Beardmix/CriticalMass_SmartBike/periph_hw/README.md

# Hardware Guide

## Electronic sketch
There is an available sketch "sketch.fzz"
It can be viewed with <a href="http://fritzing.org/home/">Fritzing</a>:

## Pre-requisites
Here is the list of all the items you will need to aquire in order to have the project up and running:
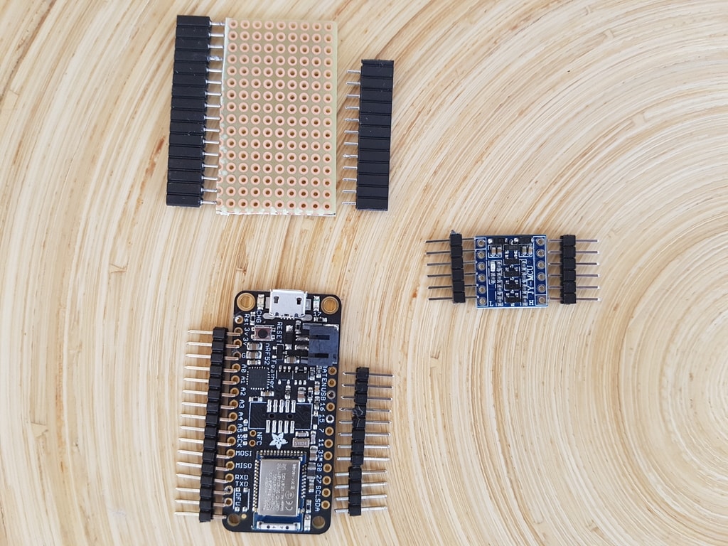
[picture p6: periph_hw/resources/pictures/step1_prerequisites.jpg]
Summary of items

1. <a href="https://www.amazon.de/gp/product/B01LXHUG4G/ref=oh_aui_search_detailpage?ie=UTF8&psc=1">WS2812B LED Strip</a>
1. <a href="https://www.amazon.de/Adafruit-Feather-nRF52-Bluefruit-LE/dp/B071ZSQDSJ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">Adafruit Feather nRF52 Bluefruit LE</a>
2. 3.3V to 5V logic shifter like the
<a href="https://www.amazon.de/XCSOURCE%C2%AE-Logisches-Konverter-Bi-Direktional-TE291/dp/B0148BLZGE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">XCSOURCE Bi-directional logic shifter</a>
3. <a href="https://www.amazon.de/WITTKOWARE-Punktraster-experimentierplatine-100x160x1-35%C2%B5m/dp/B07CHQYSTG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">Soldering board</a>
4. <a href="https://www.conrad.de/de/mpe-garry-buchsenleiste-praezision-anzahl-reihen-1-polzahl-je-reihe-36-115-1-036-0-mtf-xs0-1-st-733779.html">Pin headers female</a>
5. <a href="https://www.amazon.de/OneCreation-m%C3%A4nnlicher-weiblicher-LED-Verbindungsst%C3%BCck-Kabel-LED-Streifen-Lampe/dp/B01DA5QB04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">JST-SM cable connectors</a>
6. <a href="https://www.conrad.de/de/strapubox-mg-2-a-modul-gehaeuse-55-x-36-x-30-abs-grau-1-st-522341.html">Wrapping box</a>

## Step by Step assembling
### 1. Soldering the pin headers on the boards
| Front | Back |
| --- | --- |
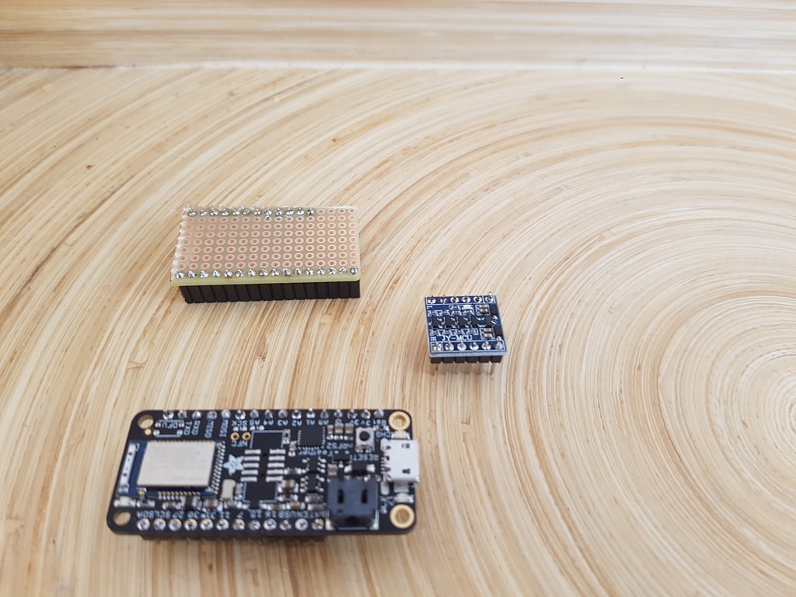
[picture p7: periph_hw/resources/pictures/step2_soldering_back.jpg]
Soldering, back-side view
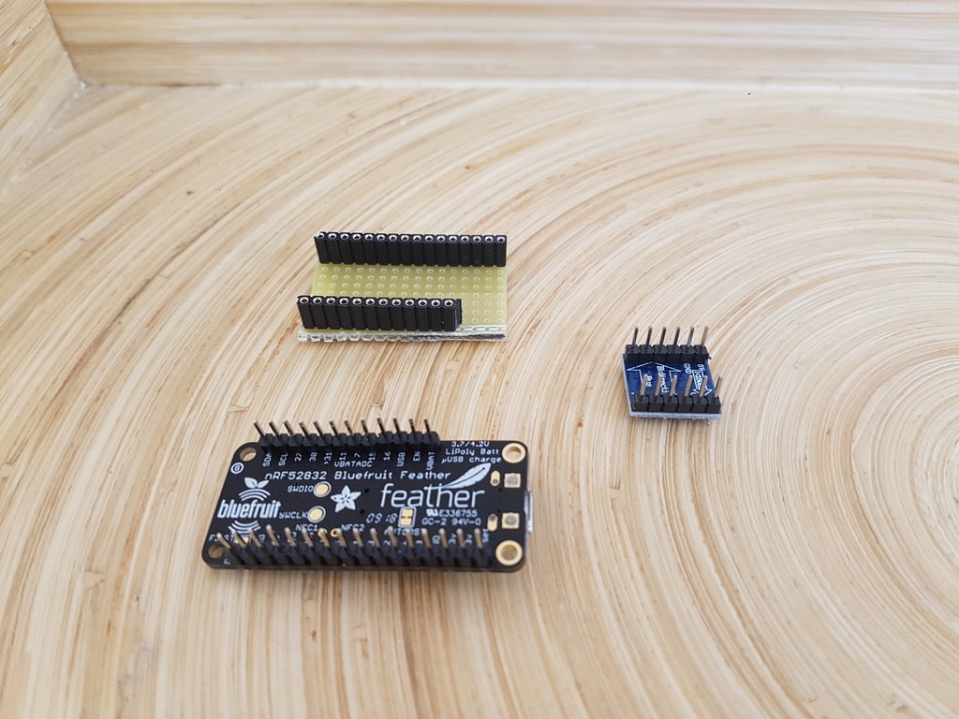
[picture p8: periph_hw/resources/pictures/step2_soldering_front.jpg]
Soldering, front-side view
|  |  |

### 2. Soldering the logic shifter on the soldering board
| Front | Back |
| --- | --- |
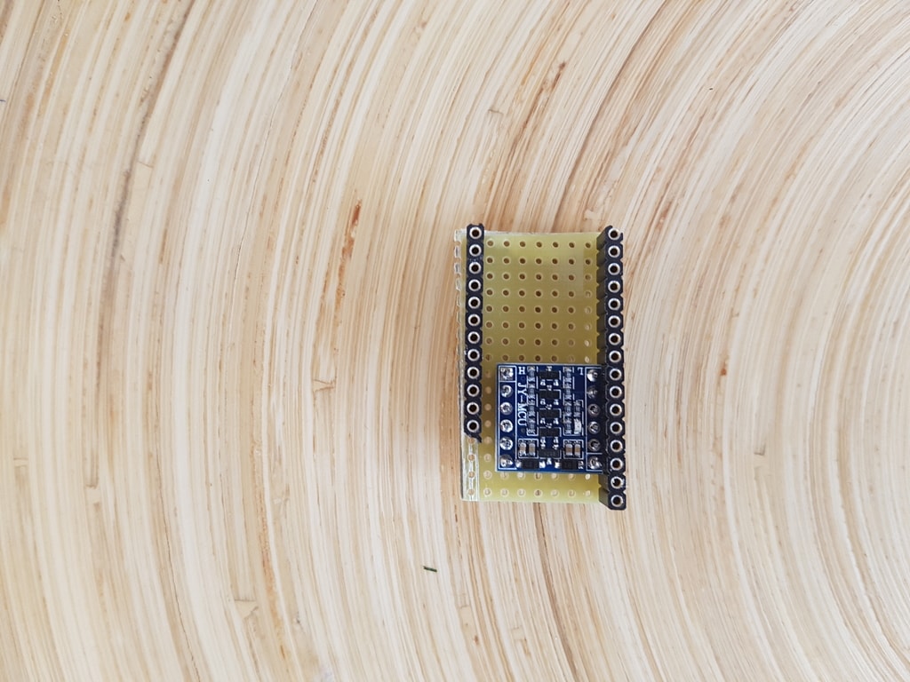
[picture p9: periph_hw/resources/pictures/step3_soldering_logic_shifter_front.jpg]
Soldering the logic shifter, front-side view
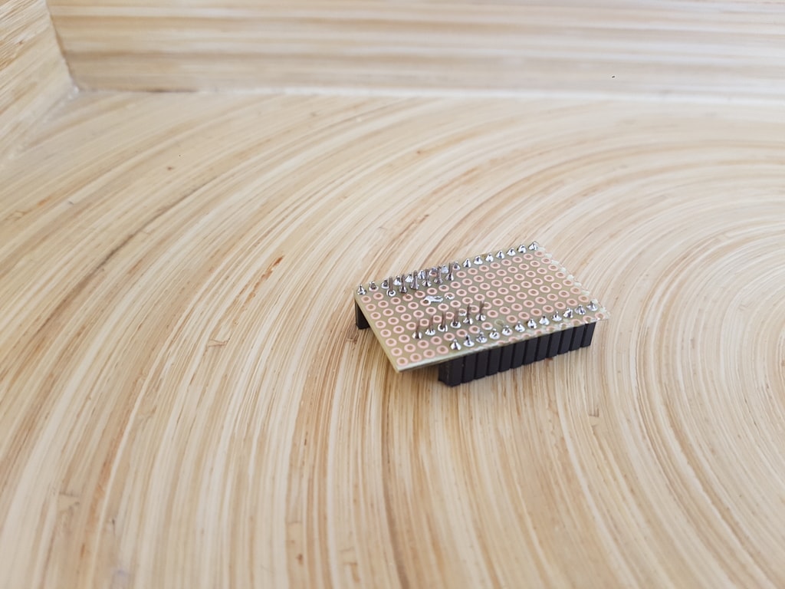
[picture p10: periph_hw/resources/pictures/step3_soldering_logic_shifter_back.jpg]
Soldering the logic shifter, back-side view
|  |  |

### 3. Soldering GND and VCC between nRF52 and logic shifter
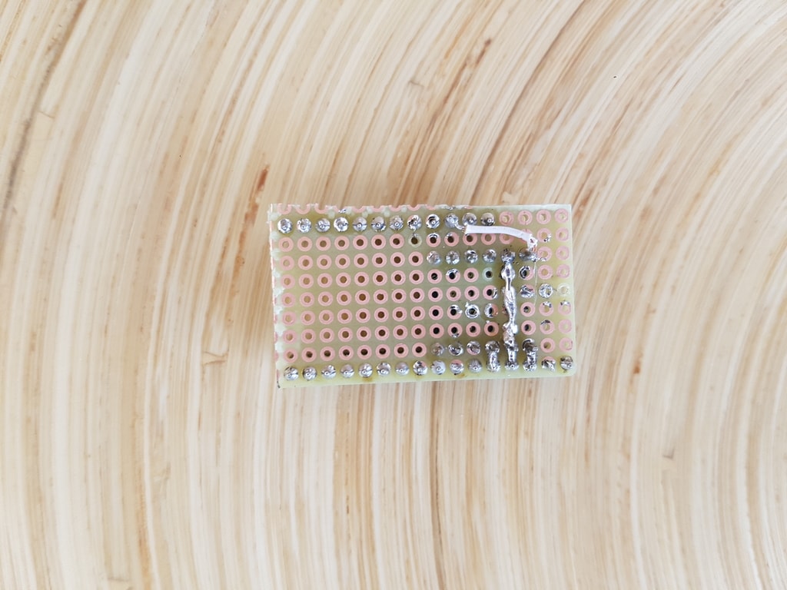
[picture p11: periph_hw/resources/pictures/step4_soldering_gnd_and_vcc.jpg]
GND and VCC connections

### 4. Connecting the LED cable, to test the connections
| Off | On |
| --- | --- |
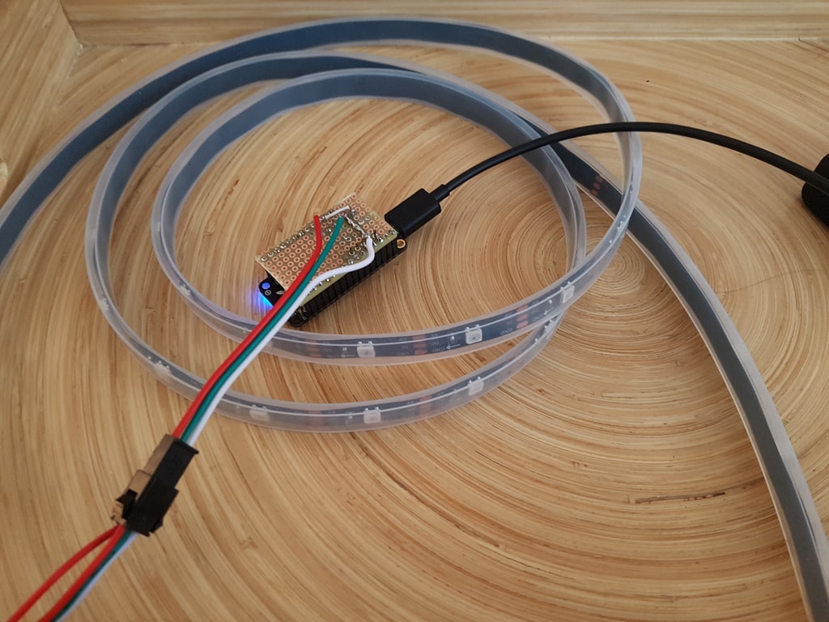
[picture p12: periph_hw/resources/pictures/step5_led_connect_off.jpg]
LED Cable connection, offline
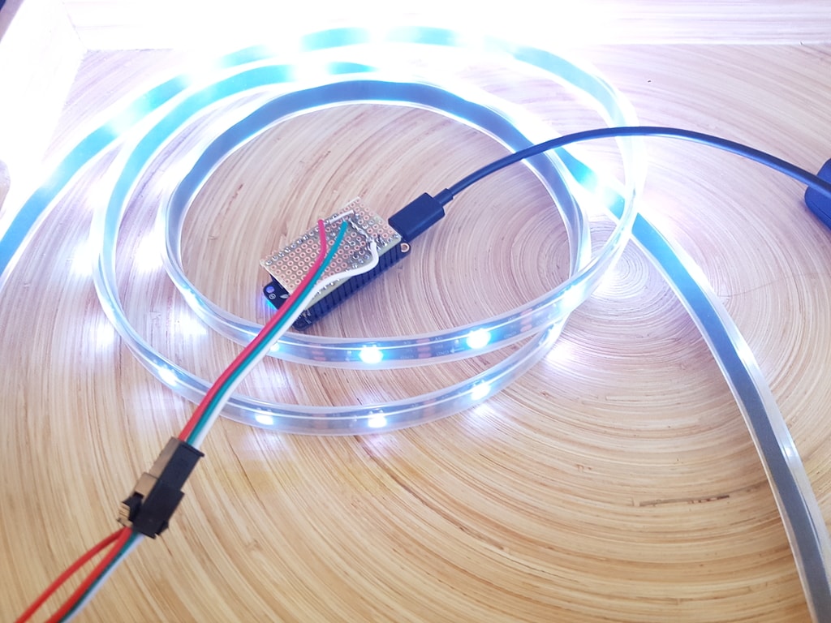
[picture p13: periph_hw/resources/pictures/step5_led_connect_on.jpg]
LED Cable connection, online
|  |  |

### 5. Installing the device in the box
| Cable connecions | Off | On |
| --- | --- | --- |
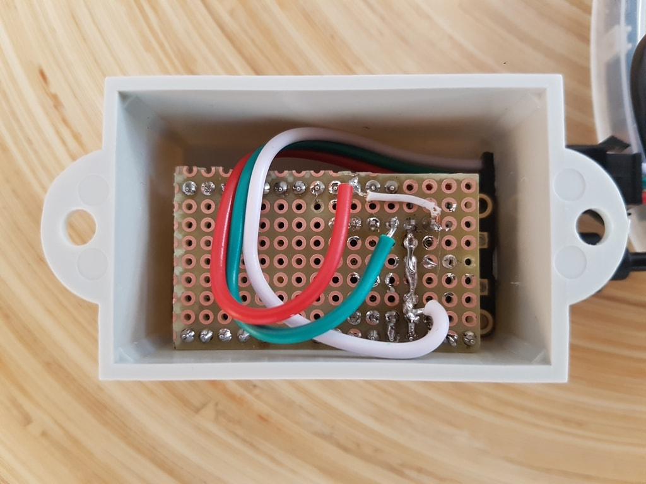
[picture p14: periph_hw/resources/pictures/step6_wrapping_connections.jpg]
LED cable connections
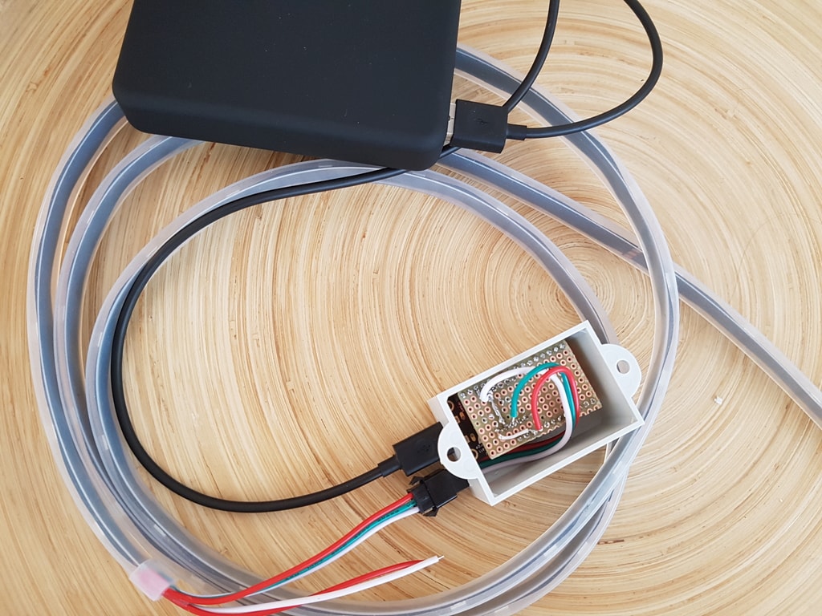
[picture p15: periph_hw/resources/pictures/step6_wrapping_box_off.jpg]
Box wrap-up, offline
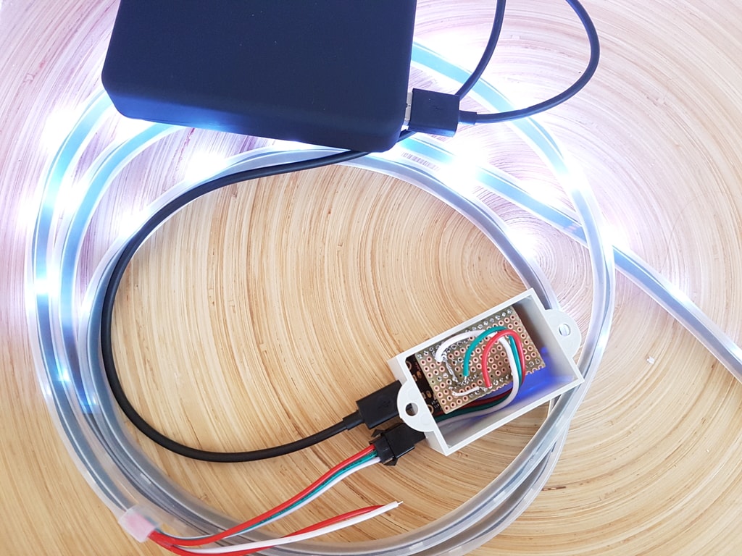
[picture p16: periph_hw/resources/pictures/step6_wrapping_box_on.jpg]
Box wrap-up, online
|  |  |  |
