Beardmix/CriticalMass_SmartBike/(threads)

Thread 12 (2018-06-17):

Peripheral crashes when disconnected from Master

OnizukaX, 2018-06-17:
When the Master disconnects from the Peripherals, Peripherals might crash. Rootcause unknown.

OnizukaX, 2018-06-18:
After some testing, this seems to have to do with the Adafruit_NeoPixel library.
Having the strip.show() calls commented out keeps the Peripheral working when disconnected from Central: are interrupts responsible?

OnizukaX, 2018-06-18:
Refering to the task scheduler section of the nRF52 doc: https://learn.adafruit.com/bluefruit-nrf52-feather-learning-guide/faqs#faq-5
> How are Arduino sketches executed on the nRF52832? Can I do hard real time processing (bit-banging NeoPixels, etc.)?
In order to run Arduino code on the nRF52 at the same time as the low level Bluetooth Low Energy stack, the Bluefruit nRF52 Feather uses FreeRTOS as a task scheduler. The scheduler will automatically switch between tasks, assigning clock cycles to the highest priority task at a given moment. This process is generally transparent to you, although it can have implications if you have hard real time requirements. There is no guarantee on the nRF52832 to meet hard timing requirements when the radio is enabled an being actively used for Bluetooth Low Energy. This isn't possible on the nRF52832 even without FreeRTOS, though, since the SoftDevice (Nordic's propietary binary blob stack) has higher priority than any user code, including control over interrupt handlers.

Refering to the FreeRTOS hook functions: https://www.freertos.org/a00016.html

So far no hooks seems to handle this unknown issue.

OnizukaX, 2018-09-30:
Problem still occuring with Adafruit nrf52 Arduino Core 0.8.6.

Somehow almost no crash seem to happen when compiling with:
**Debug Mode: "Level 3 (Segger SystemView)"**.

wwwoholic, 2018-11-18:
Still occurring with 0.9.0
I noticed that it is easier to trigger this error if nodes are actively exchanging data (100~300 Bps) and one of the nodes is simply rebooted.

OnizukaX, 2019-04-06:
Solved in v1.1.8 - https://github.com/adafruit/Adafruit_NeoPixel/releases/tag/1.1.8

Closed 2019-04-06.

Thread 2 (2018-06-17):

Adding Settings to Arduino

Beardmix, 2018-06-17:
When connected to a single bike, the owner should be able to personalize the settings of the lights.

For example:
- Number of LEDs
- Name of the bike
- Mounting Style (from front to rear, as a triangle, ...)
- ...

The phone has to have a settings menu
The peripheral has to be able to save in the EEPROM
The peripheral has to be able to retrieve from the EEPROM
A communication of the settings has to be set (from periph to phone and from phone to periph)

Beardmix, 2018-06-17:
The Library EEPROM is not accessible for the hardware. (EEPROM.h is not found)
Instead, tried to use Nffs which is also the one used from Adafruit.
Issues while creating a new file. da95df8

Beardmix, 2018-06-18:
NFFS could not write to the eeprom as the memory was full (filled with paired devices).
Using the examples from the library did not work neither, until using the example to clear the memory.
`EraseNffs.ino` is the script to use to clear the memory. An adaptation could be made to limit the space taken by the paired devices.

Could this also be linked to other issues?

Beardmix, 2018-06-18:
Saving and Loading settings work --> bc13b2e
Default values are set and saved if no previous values.

After loading settings, they should be re-saved to incorporate default values in case one is not loaded.

Beardmix, 2018-06-19:
Sending and receiving of new settings working. Saving settings in the ROM.

Missing sending the settings at first connection.

There might be issues when the memory is full and one can not save any longer.
Maybe check for error message 3. If so, clear memory and resave.

Beardmix, 2018-06-24:
0bc8450
Interface to change name and number of LEDs created.
Still some bugs with ROM saving (errors in saving or closing the file - needs a memory clear).
No answer from the device can be sent in the `connect_callback` as the phone is not yet listening to the device.

Filter devices using Manufacturer and not Name.

Beardmix, 2018-06-24:
7046ae4

After a successful connection, the phone asks the device for its settings.

Closed 2018-07-17.

Thread 4 (2018-06-17):

Devices meshing with a Master

Beardmix, 2018-06-17:
Try to mesh the devices between them, and having a single Master (the closest to the phone?).
This would allow faster communication between devices (the BLE stack is not disturb by an OS) and increase the range of communication.
With this, it is also hoped that the time synchronization would be more accurate (due to BLE stack speed).

OnizukaX, 2018-08-16:
Depends on [Bluetooth LE Mesh open issue](https://github.com/adafruit/Adafruit_nRF52_Arduino/issues/64 )?

Thread 5 (2018-06-17):

Documentation

Beardmix, 2018-06-17:
We want to make the project available to more contributors and that it could be used without the core team's participation.
More documentation is needed in order to explain the project, the current status, how to use it, ...

A good start would be to have a more detailed ReadMe page and include a short video of demonstration.

htjjen, 2018-06-21:
I can add more details on "Install Android Studio or Only Line Command" and "Activate developer mode on your Android" - would that help?

Thread 7 (2018-06-17):

Organise Testing

Beardmix, 2018-06-17:
It is hard to test most of the features alone, and generally at least 2 devices are necessary to group features.
One should organize regularly testing events to be able to enhance the quality of the product.

Things to test:
- Time synchronization (find a protocol for testing it)
- Connection stability / robustness
- Range of connection (with or without mesh)
- ...

Thread 8 (2018-06-17):

Hardware

Beardmix, 2018-06-17:
1. Update the schematics of the wiring to correspond to actual hardware
2. Create a new schematics for a shield
3. Try to find ways to reduce costs of the hardware (the simplicity should be kept to a maximum)

Beardmix, 2018-06-17:
The Breadboard version of the schematics has been updated - see commit 1520f4b

Beardmix, 2018-07-17:
Hardware was updated to latest state at commit  3613b9f
3 Pieces ordered for testing and usage.

Closed 2018-07-17.

Thread 9 (2018-06-17):

Usage of Phone sensors

Beardmix, 2018-06-17:
Using the sensors embedded in the phone (GPS, accelerometers, light, ...) it should be possible to offer enhanced features.

Examples would be:
1. Red lights when braking
2. Blinking Orange when turning
3. Brightness related to speed
4. ...

Beardmix, 2018-06-17:
First prototype of accelerometer reading:
in branch accelerometer_brake, commit 7e1652a
it seems that the accelerometer is not read or read rarely when the app is in background mode.
The use of `backgroundMode.enable()` does not seem to improve anything.

The fact that the mode is called, the app forgets what were the previous settings after the brake.

Thread 14 (2018-06-21):

The Central deletes its internal handle to the Peripheral even though the disconnect call fails

OnizukaX, 2018-06-21:
When disconnecting all Peripherals the Central deletes all entries from its list of connected devices, either in case of success or failure.

It might however happens that a call to disconnect() fails. If so, the Peripheral will stay connected but the Central will not be able to interact with it anymore -> the Peripheral has to be reset.

OnizukaX, 2019-06-10:
Seems not to happen anymore with the new data workflow.

Closed 2019-06-10.

Thread 19 (2018-07-19):

Each Peripheral shall be able to define its lightning direction

OnizukaX, 2018-07-19:
Some "modes" have a lightning direction" (e.g. Theater chase, Pile up, Rainbow), the Peripheral shall retain and be able to modify its LED strip "mounting direction".

OnizukaX, 2018-08-21:
See pull request #27 for details.

note: one might be interested in changing the direction without saving the parameter into the settings file e.g. alternating modes etc. In this case, please create a new issue.

Closed 2018-08-21.

Thread 21 (2018-07-19):

Long-press should pop-up advanced options and choices which will be saved as default

artur-braga, 2018-07-19:
Each color, intensity or modes(if more available) button could be reconfigured with a new preset,
With one long-press, a pop-over will appear with more choices and presets. These can be either chosen only once, or saved as default preset for the respective button.
[Optional]:
* Reset to default App Settings
* Load/Save Custom presets for all the buttons
* Sync presets between phones

Thread 26 (2018-08-20):

Light effects are not looping on schedule when the tempo is not 60bpm

Beardmix, 2018-08-20:
The effects are made to work on a basis of 1 loop per second.
When the tempo is faster, the effect is still not finished when the loop has to start.
This produces a glitch effect in the lights that diminishes the quality of the product.

Beardmix, 2018-08-21:
Issue is not due to millis method but to the smartphone time sync.
Even if the server sends the information at the same time for each device, the devices are not synced.
Test: send server time on button push -> no sync.
Even with a single device connected, pushing the button de-synchronises the peripheral.

[solved] Issue1: The payload used to compute the server time was used directly (ascii code) and not converted to integers.
[solved] Issue2: The computation with Pow() is probably too long and can be interrupted. has been replaced by constant multiplications.
[todo] Issue3: Using a binary system with bitshift might be more efficient are reduce computation time, which in turns reduces the chances of interruption.

There are still some sporadic wrong offsets. It is probably due to interruptions.
It is possible to average or filter extreme values.

[todo]: Do an average of received time offsets (careful with overflows around 0)
[todo]: Test with multiple devices

commit: edc344a7d6ec71941dc5b42f3395ba5273174ea4

Beardmix, 2018-08-28:
fixed in commit 09388d20ab755eb6eee53ad2ebed6b4c5854f4c9

Closed 2018-08-28.

Thread 30 (2018-09-03):

Automatically determine the strip number of LEDs

OnizukaX, 2018-09-03:
At startup, the Peripheral should be able to determine how many LEDs the strip has (e.g. by reading the battery voltage level when successively adressing the LED 0..n).

The option to let the user decide how many he wants to control should be kept, only the default value is to be set during the initialisation.

OnizukaX, 2019-04-06:
Cancelled as we are not able to read the voltage level. Related to #32

Closed 2019-04-06.

Thread 31 (2018-09-05):

Crash every time the parameters are saved manually

Beardmix, 2018-09-05:
Every time the parameters are saved, the device crashes while saving, saving only a part of the parameters, and preventing further savings.
The first saving works (the one automatic after reflashing the ROM)

The error code is 2, which is define in fs.h as:
`#define FS_EHW          2  /* Error accessing storage medium */`
[https://github.com/adafruit/Adafruit_nRF52_Arduino/blob/master/libraries/nffs/src/fs/fs/include/fs/fs.h]

usually, the error was `#define FS_EOFFSET      3  /* Invalid offset */`, which was more cryptic and happened while the device was not crashing.

It is probably due to BLE interrupts, or size of parameters to save?

Full log here:

```
--- Peripheral---

File /settings.txt not found.
--------- SoftDevice Config ---------
Max UUID128     : 10
ATTR Table Size : 2048
Service Changed : 0
Peripheral Connect Setting
  - Max MTU         : 23
  - Event Length    : 3
  - HVN Queue Size  : 1
  - WrCmd Queue Size: 1

--------- BLE Settings ---------
Name            : Bluefruit52
Max Connections : Peripheral = 1, Central = 0
Address         : D9:EF:3D:CA:77:49 (Static)
TX Power        : 0 dBm
Conn Intervals  : min = 20.00 ms, max = 30.00 ms
Peripheral Paired Devices:

Central Paired Devices:

startAdv
+++ Connected +++
Pixel 2
payload sent #T60!
payload sent #C255,128,0!
payload sent #M8!
[SETTINGS] request cfg, will send chunk#1
payload sent #D1;50;0;MyFahrrad!
[SETTINGS] request cfg, will send chunk#2
payload sent #D2;1;11;38;50!
[SETTINGS] request cfg done.
[SETTINGS] ready to get cfg chunk#1
payload sent #DA!
[SETTINGS] getting cfg chunk#1 ask for chunk#2
0
payload sent #DB!
[SETTINGS] getting chunk#2
Open /settings.txt file to write ...
Writting Setting: num_pixels=50;
Writting Setting: strip_rev=0;
Writting Setting: d_name=MyFahrrad;
Writting Setting: traffic_fl=1;
Writting Setting: traffic_fu=11;
Writting Setting: traffic_rl=38;
Writting Setting: traffic_ru=50;
payload sent #S801!
payload sent #S170!
payload sent #S390!
payload sent #S950!
payload sent #S280!
payload sent #S870!
payload sent #S001!
[SETTINGS] ready to get cfg chunk#1
payload sent #DA!
[SETTINGS] getting cfg chunk#1 ask for chunk#2
1
payload sent #DB!
[SETTINGS] getting chunk#2
Open /settings.txt file to write ...
Writting Setting: num_pixels=50;
Writting Setting: strip_rev=1;
Writting Setting: d_name=Sophie;
Writting Setting: traffic_fl=42;
Error - len_written: 0 | file.errnum: 2
Writting Setting: traffic_fu=50;

```

Beardmix, 2018-09-05:
Complement:
This is the content of the ROM after a saving failure:

```
root
|_ adafruit/
|  |_ bond/
|_ lost+found/
|_ settings.txt                                    98 Bytes

```

Nothing is suspicious..

Erasing the ROM as in the example is not possible when integrated in the code (see issue on Adafruit Repo). Erasing fails after one sector successfully erased, and the file cannot be written afterwards, even if it doesn't trigger any error!

OnizukaX, 2019-06-10:
Seems to be resolved with all the latest file system changes.
 [Adafruit nRF52 v0.11.0](https://github.com/adafruit/Adafruit_nRF52_Arduino/releases/tag/0.11.0) looks fine.

Closed 2019-06-10.

Thread 32 (2018-09-06):

Display battery level

OnizukaX, 2018-09-06:
Read the Peripheral's battery level or USB-Power and display it by turning on the LEDs correponding percentage. A color indicator could be also chosen.

OnizukaX, 2019-04-06:
Battery regulators prevent battery voltage reading. Activity cancelled as we want to use plugNplay powerbanks.

Closed 2019-04-06.
