Beardmix/CriticalMass_SmartBike/(list of files, drawings)

Other design files:
periph_hw/sketch.fzz
