Beardmix/CriticalMass_SmartBike/(commit log)

2018-03-27 BLE - Fixing packet reading. BLE - Send time pull request. PhoneApp - Answer Time Request
    [nRF52_RGB_Strip.ino]
2018-03-27 BLE - use correct pin number. PhoneApp - Clean code with functions.
    [nRF52_RGB_Strip.ino]
2018-03-27 PhoneApp - Modify UI to automatically connect to MyFahrrad devices.
2018-03-30 BLE - Adding Debug Pin. Adding Flow mode
2018-03-30 BLE - Adding missing pin declaration
    [nRF52_RGB_Strip.ino]
2018-04-01 BLE - Fix decode RGB. PhoneApp - Fix encode RGB
    [nRF52_RGB_Strip.ino]
2018-04-01 HW - Adding schematics for the hardware shield
    [sketch.fzz]
2018-04-14 PhoneApp - live GUI update of connected BLE devices when pairing.
2018-04-14 PhoneApp - added bicycle icon and increased connected devices badge size.
2018-04-15 BLE - sending clock milliseconds after offset addition.
2018-04-17 PhoneApp - master initiates universal time and adjusts the delay error induced by the server stack. BLE - peripheral listens to the master to set its universal time reference.
    [led_lib.h, nRF52_RGB_Strip.ino]
2018-04-18 PhoneApp - Connecting to devices every 20s as long as not actively disconnecting.
2018-04-18 PhoneApp - Resending Mode to newly connected devices.
2018-05-07 BLE - Replacing LED control with NeoPixel Lib
2018-05-08 BLE - fix chase mode
    [led_lib.h]
2018-05-24 BLE - single access to millis(); the led library could also get a pointer to the global counter to eliminate its internal calls.
2018-05-24 PhoneApp - added "theater chase mode" button.
2018-05-31 PhoneApp - Fixing callbacks new devices
2018-05-31 BLE - Fix global variable crash
    [nRF52_RGB_Strip.ino]
2018-05-31 PhoneApp - Revert back to 2 connection buttons
2018-05-31 BLE PhoneApp - Fix first connection issues
    [nRF52_RGB_Strip.ino]
2018-06-04 BLE - moved the packet reading to the main sketch. Added some gates to lower the risk of having runtime issues.
    [nRF52_RGB_Strip.ino]
2018-06-04 BLE - added BSP configuration options to reduce the SoftDevice RAM is needed (in practice, really low impact). Printing the Bluetooth configuration at startup.
2018-06-07 BLE - reworked the NeoPixel initialisation sequence.
    [led_lib.h, nRF52_RGB_Strip.ino]
2018-06-07 BLE, Phone - removed time offset correction.
    [nRF52_RGB_Strip.ino]
2018-06-17 BLE - failing tests for EEPROM saving
    [eeprom_handler.h, nRF52_RGB_Strip.ino]
2018-06-17 update breadboard view of the hw
    [sketch.fzz]
2018-06-19 BLE - Using the name saved in the device as the BLE name
2018-06-19 BLE - Fetching the number of LEDs on the strip from the settings.
2018-06-24 BLE, Phone - filtering with Manufacturer and not Naming. Phone - Interface to change Name and number of LEDs
2018-06-24 BLE, Phone - After a new connection, requesting for device settings
2018-07-01 PhoneApp - Replacing Segments by Buttons to be able to align them as desired.
2018-07-01 PhoneApp - Change the scan buttons to a toggle. Fix the refresher.
2018-07-16 HW - Update Hardware for ordering.
    [sketch.fzz]
2018-07-19 BLE - Adding LED Strip link in the documentation
2018-08-05 Fixed settings transmission issue - split parameters into chunks (max 20 Bytes for the nrf52).
    [eeprom_handler.h, nRF52_RGB_Strip.ino]
2018-08-07 Fixed off-by-one for TrafficMode. Changed TrafficMode "sig_" param. naming for "traffic_".
    [eeprom_handler.h, led_lib.h, nRF52_RGB_Strip.ino]
2018-08-09 Fixed LEDs reminiscence issue when changing num_pixels to a smaller value - "deactivated" pixels were not controlled anymore and stayed in their previous state.
    [led_lib.h, nRF52_RGB_Strip.ino]
2018-08-17 A Peripheral is now capable to retain its "lightning direction"; the phone app. can flip this flag via the settings popover.
    [eeprom_handler.h, nRF52_RGB_Strip.ino]
2018-08-28 #26 light effects loop millis 60bpm (#28)
    * BLE - Fix time payload computation. Change offset calculation to the milliseconds.
    * BLE - better interpretation of server time syncs.
    * BLE - Add intermediate variable
    [led_lib.h, nRF52_RGB_Strip.ino]
2018-09-02 TrafficMode now takes the strip-reverse flag into account.
    [eeprom_handler.h, nRF52_RGB_Strip.ino]
2018-09-03 #25 music rythmic modes (#29)
    * BLE - Drum Music mode first draft
    * BLE - Use a grid model to define pattern
    * BLE - Enhance drum effect
    * PhoneApp - Restoring the tap tempo and adding cue start.
    * BLE - Removing Cue. Using BPM prediction for adjusting.
    * PhoneApp - Circular array on 10 values
    * BLE - Removes unused Drum Mode. Not Working
    [led_lib.h]
2018-09-05 Filtering automatic modes by property.
2018-09-05 Packed strip is_reversed flag together with traffic indices to avoid ping-pong sync/flickering. Settings is_reversed flag directly accessed, TrafficMode implementation encapsulated in the method itse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
    [eeprom_handler.h, led_lib.h, nRF52_RGB_Strip.ino]
2018-09-05 BLE - Fixing the feedback loop by settings request. Updating the number of pixels after increasing the number.
    [eeprom_handler.h, nRF52_RGB_Strip.ino]
2018-11-03 PhoneApp - Update cloud mode instead of inserting new
2018-11-04 PhoneApp - Automatically scanning for devices. Manually selecting the devices to connect.
2018-12-06 Adding the Board version & known issues in gradle
2019-01-05 Colored platine schematic.
    [sketch.fzz]
2019-02-04 Fixed intensity for: pile-up, rainbow, traffic, flash, hue-flow and magic-wand modes.
    [led_lib.h]
2020-04-01 Added device settings screenshot.
2020-04-23 Fix the maximum brightness scale for certain modes. Conversion issues between percents and Byte (100 to 255). Dialogue between Phone and HW.
    [led_lib.h, nRF52_RGB_Strip.ino]
